maksm17/can_usb_adapter/can_usb_adapter/BOM.csv

Comment | Designator | Footprint | LCSC Part #
100nF 50V X7R | C4,C5,C6,C7,C11,C12,C13,C14 | C_0603_1608Metric | C14663
1uF 25V X5R | C2,C3 | C_0603_1608Metric | C15849
10uF 10V X5R | C1,C8 | C_0805_2012Metric | C15850
15pF 50V C0G | C9,C10 | C_0603_1608Metric | C1644
PESD2CANFD24V-T (CAN ESD) | D1,D2 | SOT-23 | C5180309
LED red 0603 (KT-0603R) | D3,D4,D5 | LED_0603_1608Metric | C2286
Ferrite 100R@100MHz 0805 800mA (GZ2012D101TF) | FB1 | L_0805_2012Metric | C1015
USB-C HRO TYPE-C-31-M-12 | J1 | USB_C_Receptacle_HRO_TYPE-C-31-M-12 | C165948
JST GH SM03B-GHS-TB | J3,J4 | JST_GH_SM03B-GHS-TB_1x03-1MP_P1.25mm_Horizontal | C514175
5.1kOhm 1% 0603 | R1,R2 | R_0603_1608Metric | C23186
10kOhm 1% 0603 | R3,R5 | R_0603_1608Metric | C25804
120Ohm 1% 0603 | R4,R6 | R_0603_1608Metric | C22787
1kOhm 1% 0603 | R7,R8,R9 | R_0603_1608Metric | C21190
USBLC6-2SC6 | U1 | SOT-23-6 | C7519
AP2112K-3.3TRG1 | U2 | SOT-23-5 | C23380830
STM32G0B1CBT6 | U3 | LQFP-48_7x7mm_P0.5mm | C2847904
TJA1051T/3 | U4,U5 | SOIC-8_3.9x4.9mm_P1.27mm | C5342108
8MHz crystal 3225 | Y1 | Crystal_SMD_3225-4Pin_3.2x2.5mm | C57131
