maksm17/can_usb_adapter/can_usb_adapter/can_usb_adapter.kicad_pcb

## KiCad design can_usb_adapter/can_usb_adapter.kicad_pcb (2026-10-28)

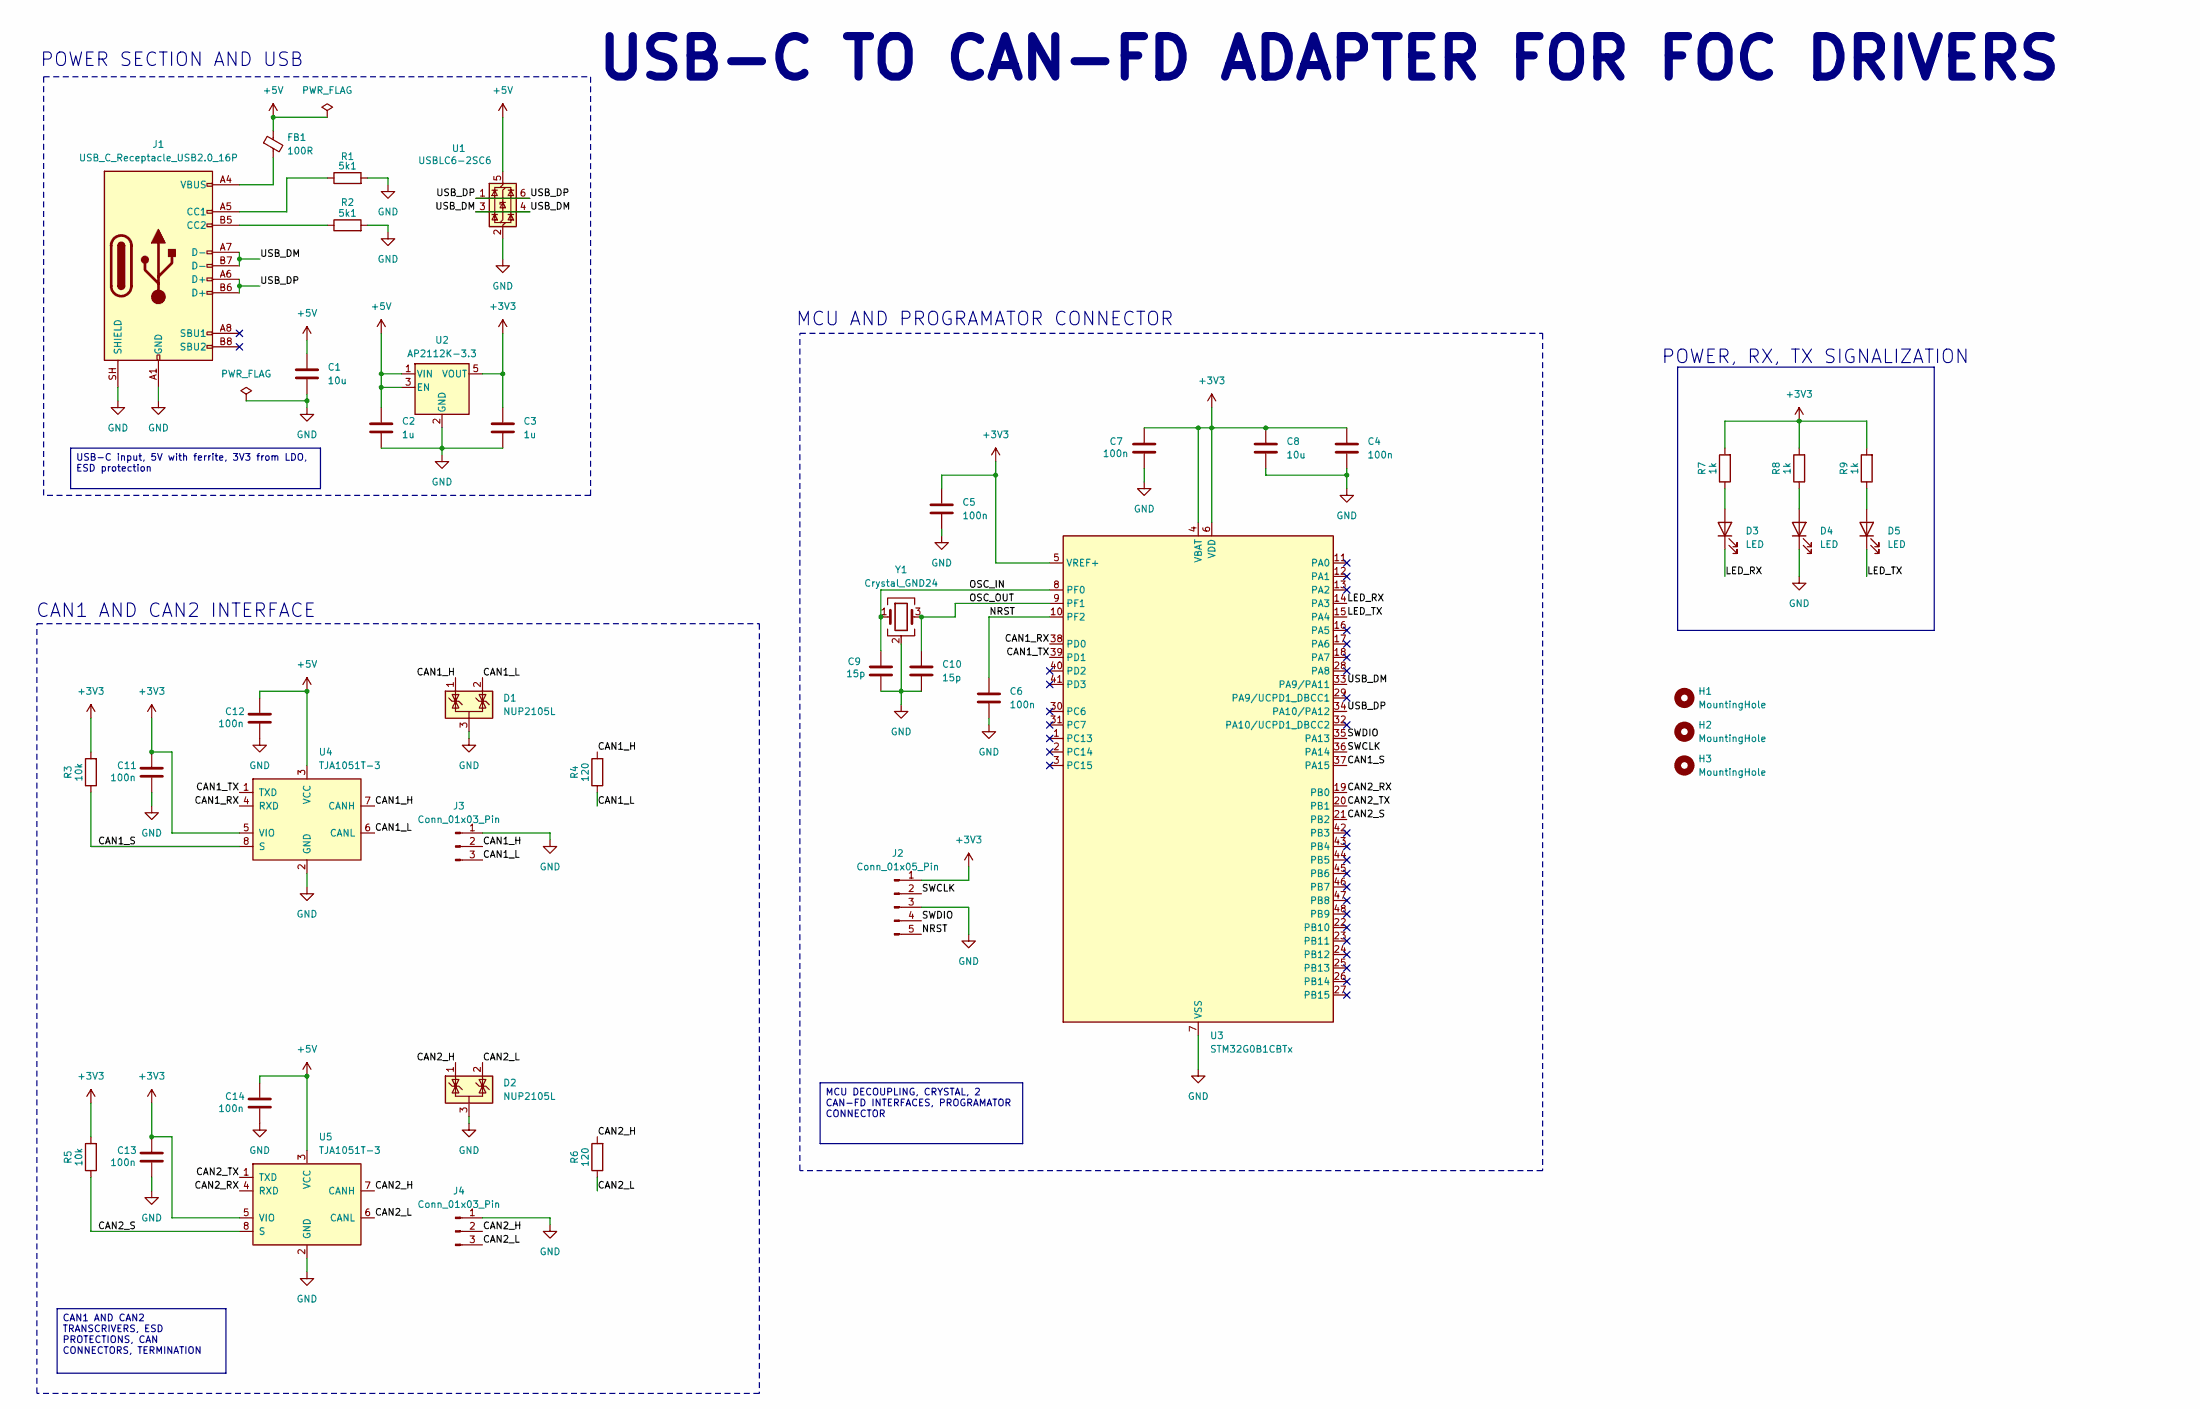
[picture p1: schematic can_usb_adapter.kicad_sch, USB-C to CAN-FD adapter]

Parts:
C1, C8: 10u; C_0805_2012Metric
C2, C3: 1u; C_0603_1608Metric
C4, C5, C6, C7, C11, C12, C13, C14: 100n; C_0603_1608Metric
C9, C10: 15p; C_0603_1608Metric
D1, D2: NUP2105L; SOT-23
D3, D4, D5: LED; LED_0603_1608Metric
FB1: 100R; L_0805_2012Metric
H1, H2, H3: MountingHole; MountingHole_2.2mm_M2
J1: USB_C_Receptacle_USB2.0_16P; USB_C_Receptacle_HRO_TYPE-C-31-M-12
J2: Conn_01x05_Pin; PinHeader_1x05_P2.54mm_Vertical
J3, J4: Conn_01x03_Pin; JST_GH_SM03B-GHS-TB_1x03-1MP_P1.25mm_Horizontal
R1, R2: 5k1; R_0603_1608Metric
R3, R5: 10k; R_0603_1608Metric
R4, R6: 120; R_0603_1608Metric
R7, R8, R9: 1k; R_0603_1608Metric
U1: USBLC6-2SC6; SOT-23-6
U2: AP2112K-3.3; SOT-23-5
U3: STM32G0B1CBTx; LQFP-48_7x7mm_P0.5mm
U4, U5: TJA1051T-3; SOIC-8_3.9x4.9mm_P1.27mm
Y1: Crystal_GND24; Crystal_SMD_3225-4Pin_3.2x2.5mm

Connections:
+3V3: C3.1, C4.1, C5.1, C7.2, C8.1, C11.2, C13.2, J2.1, R3.2, R5.2, R7.2, R8.2, R9.2, U2.5 (VOUT), U3.4 (VBAT), U3.5 (VREF+), U3.6 (VDD), U4.5 (VIO), U5.5 (VIO)
+5V: C1.1, C2.1, C12.2, C14.2, FB1.1, U1.5 (VBUS), U2.1 (VIN), U2.3 (EN), U4.3 (VCC), U5.3 (VCC)
/CAN1_H: D1.1 (K), J3.2, R4.2, U4.7 (CANH)
/CAN1_L: D1.2 (K), J3.3, R4.1, U4.6 (CANL)
/CAN1_RX: U3.38 (PD0), U4.4 (RXD)
/CAN1_S: R3.1, U3.37 (PA15), U4.8 (S)
/CAN1_TX: U3.39 (PD1), U4.1 (TXD)
/CAN2_H: D2.1 (K), J4.2, R6.2, U5.7 (CANH)
/CAN2_L: D2.2 (K), J4.3, R6.1, U5.6 (CANL)
/CAN2_RX: U3.19 (PB0), U5.4 (RXD)
/CAN2_S: R5.1, U3.21 (PB2), U5.8 (S)
/CAN2_TX: U3.20 (PB1), U5.1 (TXD)
/LED_RX: D3.1 (K), U3.14 (PA3)
/LED_TX: D5.1 (K), U3.15 (PA4)
/NRST: C6.1, J2.5, U3.10 (PF2)
/OSC_IN: C9.1, U3.8 (PF0), Y1.1
/OSC_OUT: C10.1, U3.9 (PF1), Y1.3
/SWCLK: J2.2, U3.36 (PA14)
/SWDIO: J2.4, U3.35 (PA13)
/USB_DM: J1.A7 (D-), J1.B7 (D-), U1.3 (I/O2), U1.4 (I/O2), U3.33 (PA9/PA11)
/USB_DP: J1.A6 (D+), J1.B6 (D+), U1.1 (I/O1), U1.6 (I/O1), U3.34 (PA10/PA12)
GND: C1.2, C2.2, C3.2, C4.2, C5.2, C6.2, C7.1, C8.2, C9.2, C10.2, C11.1, C12.1, C13.1, C14.1, D1.3 (A), D2.3 (A), D4.1 (K), J1.A1 (GND), J1.A12 (GND), J1.B1 (GND), J1.B12 (GND), J1.SH (SHIELD), J2.3, J3.1, J4.1, R1.2, R2.2, U1.2 (GND), U2.2 (GND), U3.7 (VSS), U4.2 (GND), U5.2 (GND), Y1.2 (G), Y1.4 (G)
unnamed: D3.2 (A), R7.1
unnamed: D4.2 (A), R8.1
unnamed: D5.2 (A), R9.1
unnamed: FB1.2, J1.A4 (VBUS), J1.A9 (VBUS), J1.B4 (VBUS), J1.B9 (VBUS)
unnamed: J1.A5 (CC1), R1.1
unnamed: J1.B5 (CC2), R2.1

Notes on the sheet:
POWER SECTION AND USB
CAN1 AND CAN2 INTERFACE
USB-C TO CAN-FD ADAPTER FOR FOC DRIVERS
POWER, RX, TX SIGNALIZATION
MCU AND PROGRAMATOR CONNECTOR
CAN1 AND CAN2 TRANSCRIVERS, ESD PROTECTIONS, CAN CONNECTORS, TERMINATION
USB-C input, 5V with ferrite, 3V3 from LDO, ESD protection
MCU DECOUPLING, CRYSTAL, 2 CAN-FD INTERFACES, PROGRAMATOR CONNECTOR

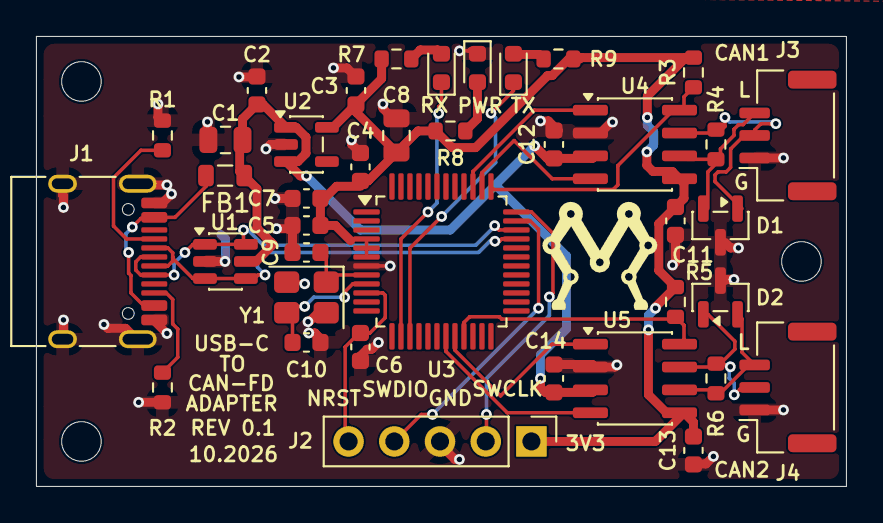
[picture p2: board can_usb_adapter.kicad_pcb from above]

Board: 2 copper layers, 45.0 x 25.0 mm, 42 parts (0 on the bottom side), 28 nets.
