maksm17/can_usb_adapter/(commit log)

2026-10-27 Scheme, ERC, footprints
    [can_usb_adapter.kicad_pcb, can_usb_adapter.kicad_sch]
2026-10-28 pcb done
    [can_usb_adapter.kicad_pcb, can_usb_adapter.kicad_sch]
2026-10-28 BOM, CPL, GERBER
    [BOM.csv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]
2026-10-28 gnd field pcb file
    [can_usb_adapter.kicad_pcb]
