maksm17/can_usb_adapter/(notices)

Notices in the files:
can_usb_adapter/can_usb_adapter.kicad_sch:
Pin mapping based on candleLightFD by Linux Automation (CERN OHL v1.2)
